OWRIG/diting-wear/enclosure/v1/sliced/toolpaths.png

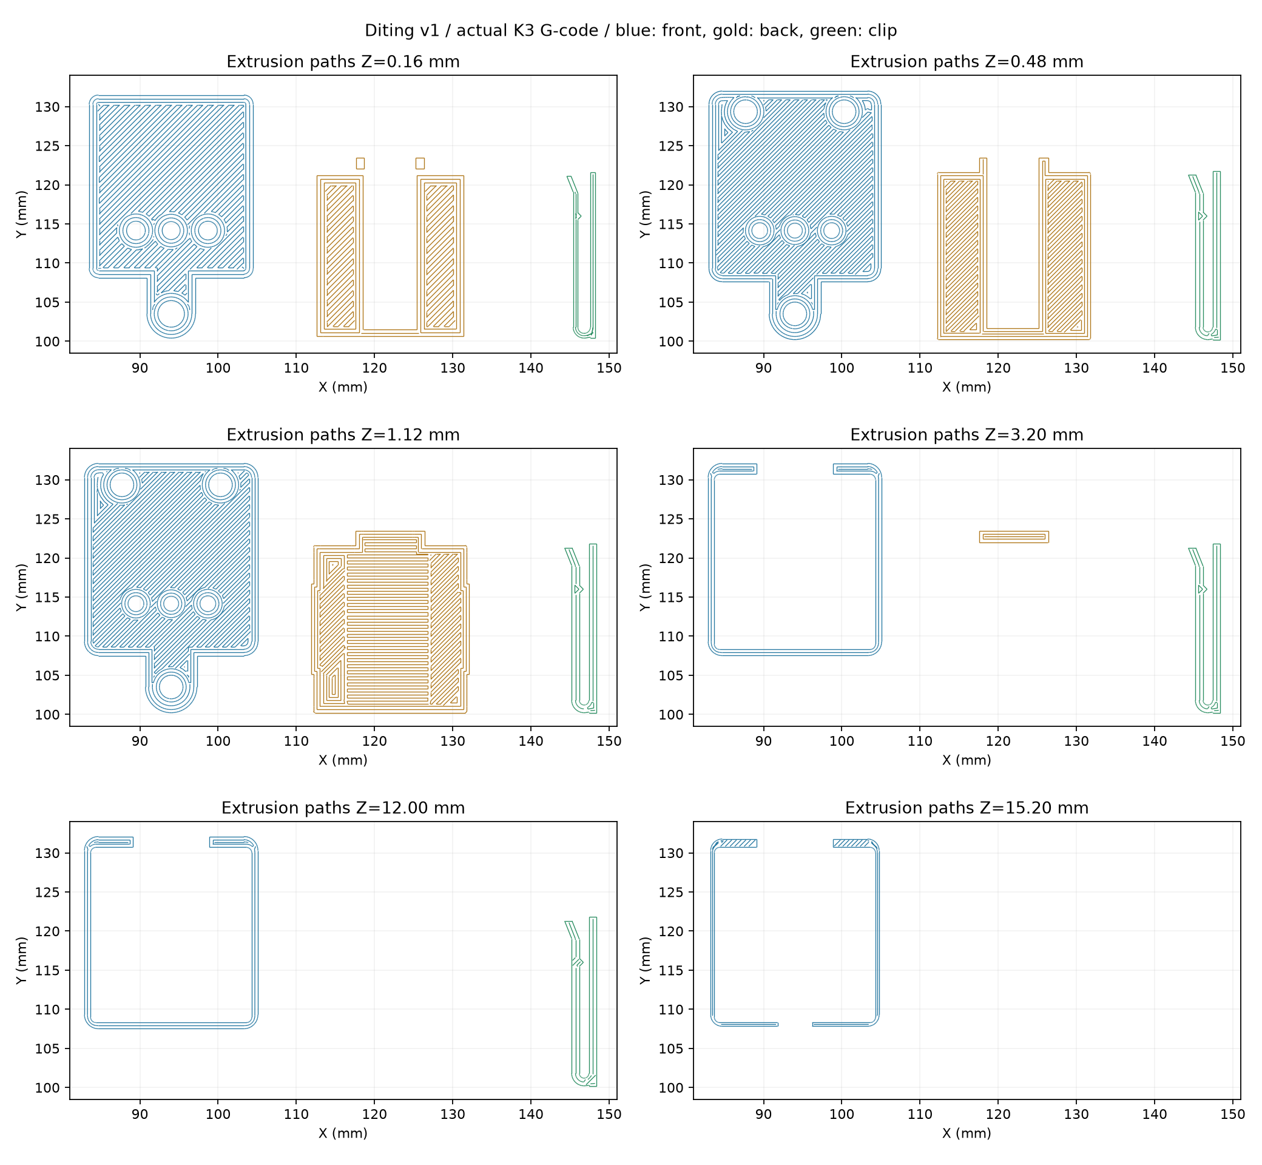
enclosure/v1/sliced/toolpaths.png
