OWRIG/diting-wear/(list of files, cad)

Other CAD files:
enclosure/v1/diting-case-v1.blend
