OWRIG/diting-wear/enclosure/v1/PRINTING.txt

谛听外壳 v1 — PLA 装配打样

1. 用 Creality Print 打开 diting-case-v1-K3.3mf，选择“打开工程”，保持100%尺寸。
   同名 .gcode 已在本机切好；3MF 是可重新切片的工程，不含刀路缓存。
2. 保持工程中的摆放：前壳正面向下，挂绳耳贴板；后盖外表面向下；背夹侧躺，+x侧朝下。
   可对照 previews/print-layout.png；三件同盘，最小间距6.35mm。
3. 工艺：K3、0.4mm喷嘴、1.75mm Hyper PLA、纹理PEI板；0.16mm层高（首层也0.16）、3墙、100%填充。
   无支撑、无brim、无skirt、无擦料塔。启动时仍有K3原配的擦嘴/排料线。
4. 本地切片估算：23分37秒，约4.70g（1.576m），共95层。
   实机准备、预热与校准会影响实际用时。预览的三种颜色用来区分零件，工程实际为单色。
5. 手动开始前确认：机型K3和0.4喷嘴正确，逻辑T0对应喷嘴/料位确实装有PLA，床面清洁且没有旧件，三件方向与预览一致。
   打印由你手动开始。待冷却后取件，再从后口放板、扣后盖；背夹从USB端滑入，朝挂绳端挡块推进。
6. 首次重点看：USB/麦克风高度是推算；燕尾斜边顶端仅约0.07mm水平间隙，桥接毛边可能使它偏紧；PLA背夹先轻压试装，确认弹性。
   保留无brim工艺时，请留意舌片两小脚的首层附着。换PETG需要选择对应材料并重新切片。
