OWRIG/diting-wear/(commit log)

2026-11-05 初始提交：硬件验证和录音固件 v1
    - 固件：PDM 麦克风 → Opus（定点、EDSP 加速）→ BLE 通知，实测 0 丢包，约 1.6KB/s
    - 测试程序：blinky、mic-level、ble-test
    - 工具：Mac 端 BLE 接收脚本 tools/ble_receiver.py
    - 文档：购物清单、家里 Mac 的转写服务部署指导
    - 第三方：libopus v1.5.2（BSD）
2026-11-05 添加 MIT 许可证
2026-11-05 固件：电池电压检测和 BLE 电池特征；焊好电池并验证电池供电
2026-11-05 安卓 App v0.1：蓝牙接收、前台服务、Ogg Opus 分段存储、播放
2026-11-05 App：按天分组显示录音、带进度条的播放器、手机端保留 7 天；服务器信箱 v1
    - 播放栏：可拖动进度条、±15 秒、播放/暂停
    - 录音列表按天分组，显示开始–结束时间和时长（从 Ogg 末页读取）
    - 每小时清理 7 天前的录音
    - server/mailbox：FastAPI 信箱（手机投递音频 / Mac 取件 / 回传文字）
2026-11-05 App：录音波形（列表小波形 + 播放栏可拖动的大波形）
    每段录音第一次显示时用 MediaCodec 解码，每 100ms 算一次音量，缓存到 files/waves。
2026-11-05 App v0.2：自动上传到信箱；服务器证书改用 DNS-01（acme.sh + DNSPod）
    - Uploader：每分钟上传未上传的录音，成功后写标记文件，失败下一轮重试
    - 服务器地址和手机 token 编译时从 .secrets/mailbox.env 注入，不进仓库
    - docs/tencent-dns-key-guide.md：创建只有 DNS 权限的腾讯云子用户密钥
2026-11-05 Mac 取件程序：信箱取音频 → 本地转写 → 回传文字，launchd 自启
2026-11-05 App v0.3：显示转写文字，完整年月日时分秒
    - 从信箱取回文字，存 files/texts（不随录音过期删除）
    - 列表：完整开始/结束时间、状态（待上传/等待转写/已转写/录音已过期）、文字摘要
    - 播放栏：当前播放的实际时刻，逐句文字（带时刻、高亮当前句、点击跳转）
    [case-back.stl, case-front.stl, clip.stl, diting-case-v1-K3.3mf, diting-case-v1.blend]
2026-11-05 App v0.4：首页改为纯文字时间线（文字/录音两个标签），状态栏收成一行
2026-11-05 声纹识别：跨录音认人、名字管理
    - 信箱：/v1/speakers（只有编号、名字、合并关系，没有声纹）
    - 取件程序 mac/speakers.py：声纹只存本机 SQLite，贪心配对、合并后保留各自声纹
    - App v0.5：人物页（起名字、合并、拆开），时间线显示说话人
    - docs/mac-speaker-guide.md：给家里 Mac 的转写服务加说话人分离
    [case-back.stl, case-front.stl, clip.stl, diting-case-v1-K3.3mf, diting-case-v1.blend]
2026-11-05 App v0.5.1：时间线把连续的句子合成段落；家里 Mac 拼长段再识别的指导
    [diting-case-v1.blend]
2026-11-05 固件：80Hz 高通 + 自动增益（只在说话帧调整、峰值限制防爆音），替换固定 ×4 增益
    在 Mac 上用同一份 C 代码离线验证：平均音量 +9dB，峰值从 -1.2dB 压到 -2dB。
    [case-back.stl, case-front.stl, clip.stl, diting-case-v1-K3.3mf, diting-case-v1.blend]
2026-11-05 认人：不登记没说话的空说话人、同文件内相似的说话人先合并、允许多个本地说话人认成同一人；App：人物页可以听一下/按说过的话排序，文字页点 ▶ 和人名，电量显示百分比
2026-11-05 App 改版：卡片布局、左右滑动切换标签、新播放器（图标按钮、±10秒、可收起的逐句文字）、状态改成底部弹出；文字按事件分组（时间·地点·人物）；新增地点：录音时每 5 分钟定位，200 米内归为同一地点，可改名/合并，只存在手机上
2026-11-05 App：锁屏或切到后台时暂停播放
2026-11-05 App：手机上用 Silero VAD 判断有没有人声，没有人声的录音不上传（本地照常保留 7 天）；上传放到单独线程
    门槛 0.25 秒人声，用 12 段真实录音标定：无人声 0–0.6 秒，有人声 1.1–44 秒。
2026-11-05 地点：用系统地址服务自动取名（小区/大厦名 + 区·路），不再显示未命名；查不到时显示经纬度并稍后补查；按最近去过排序
2026-11-05 安静时不发送：固件按帧序号发包，安静时每秒发一个只有序号的安静声明，开口时补发 0.4 秒缓存、停声后再发 3 秒；App 用静音补齐时间线、整段安静的文件直接删、状态里显示安静省略比例；定位改成只用网络定位
